dinoboards/V9958-Super/README.md

This repository has moved to Codeberg.

[https://codeberg.org/dinoboards/V9958-Super](https://codeberg.org/dinoboards/V9958-Super)

This repository is not mirrored.
