dinoboards/V9958-Super/docs/pcb-render.png

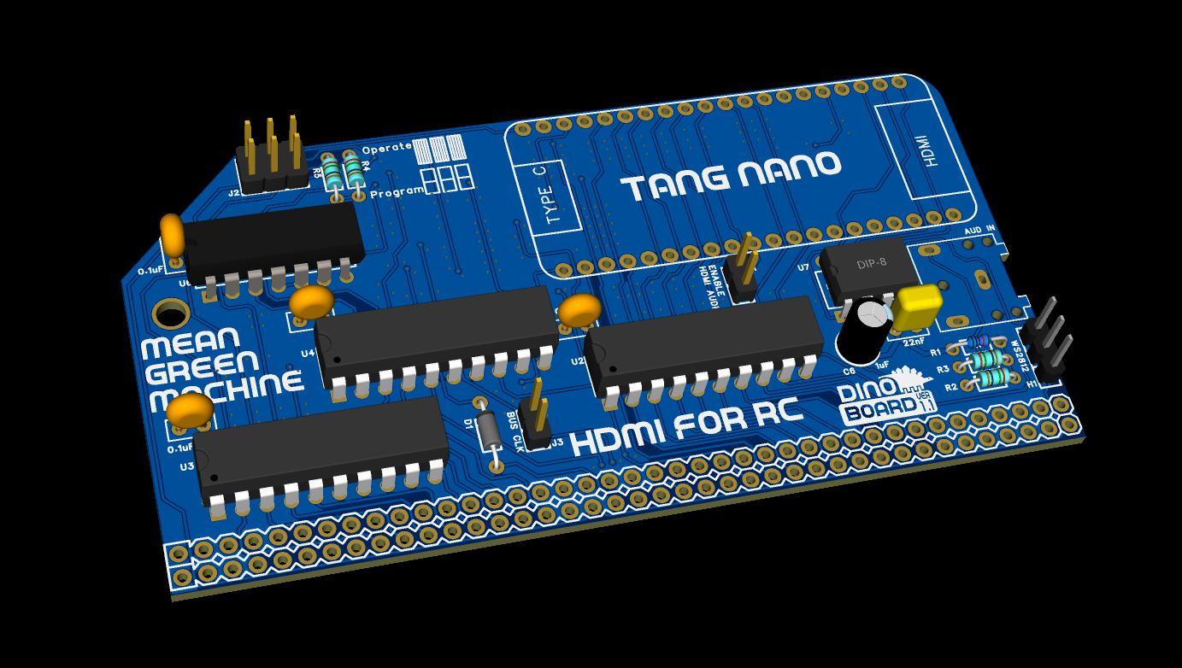
docs/pcb-render.png
