dinoboards/V9958-Super/(threads)

Thread 1 (2025-07-24):

TN GPIO pins 25 & 26 swapped in v9958.cst?

codesmythe, 2025-07-24:
Hi Dean,

Very nice work on this video board! I am particularly excited about your extensions to 640x480, etc video.

I had started down a similar path of a V9958 FPGA device hosted on the RCBus, but did not get very far. I did get a TN20K to RCBus host board designed and while adapting my schematic to your pinout, I noticed that pins TN20K pins 25 & 26  are swapped in the `v9958.cst` file compared to the schematic and PCB layout files you have published.

In the schematic and PCB layout files, TN_INT appears to be connected to TN GPIO pin 25, but `v9958.cst` has this line:

```
IO_LOC "int_n" 26;
```

Similarly, in the schematic and PCB layout files, the TN_25 signal (now misnamed?) (aka "exclude audio") appears to be connected to TN GPIO 26, but `v9958.cst` has this line:

```
IO_LOC "exclude_audio" 25
```

Anyway, nice job! I look forward to playing with the stuff you have made.

dinoboards, 2025-07-24:
Hi Rob,

Very good catch - i had completely forgotten about this issue.  And with my usual lack of discipline in documenting, I had to 'relearn' the issue again.

I did go through a small panic, until i had recalled and then doubled check.  Everything works - so...

The problem is in the footprint for the TN20K module.  The labels for those pins on the **Tang Nano 20K**  are wrong.  Hence why the trace `TN_25` seems to connect to TN20K's `26` pin.

I used EasyEDA for the schematic, and no doubt found a public version of the footprint --- and then discovered later the issue.  I need to update the footprint labels to avoid this confusion (I will leave this issue open as task to do that)

*I have a vague recall that there may have been a typo in a previous version of pinout diagram from Sipeed - and the footprint may have inherited that type - but I could be having an AI moment?*

I have also added a small note in the docs folder : [tn20k-pin-naming-discrepency.md](https://github.com/dinoboards/V9958-Super/blob/main/docs/tn20k-pin-naming-discrepency.md)

---

> Very nice work on this video board! I am particularly excited about your extensions to 640x480, etc video.

Thanks (despite the schematic confusion...)

dinoboards, 2025-07-27:
The schematic file has been updated with correct labels/pin assignement for the Tang Nano 20K - https://github.com/dinoboards/V9958-Super/blob/main/docs/schematic.pdf

Closed 2025-07-27.
