dinoboards/V9958-Super/docs/schematic1.1.pdf

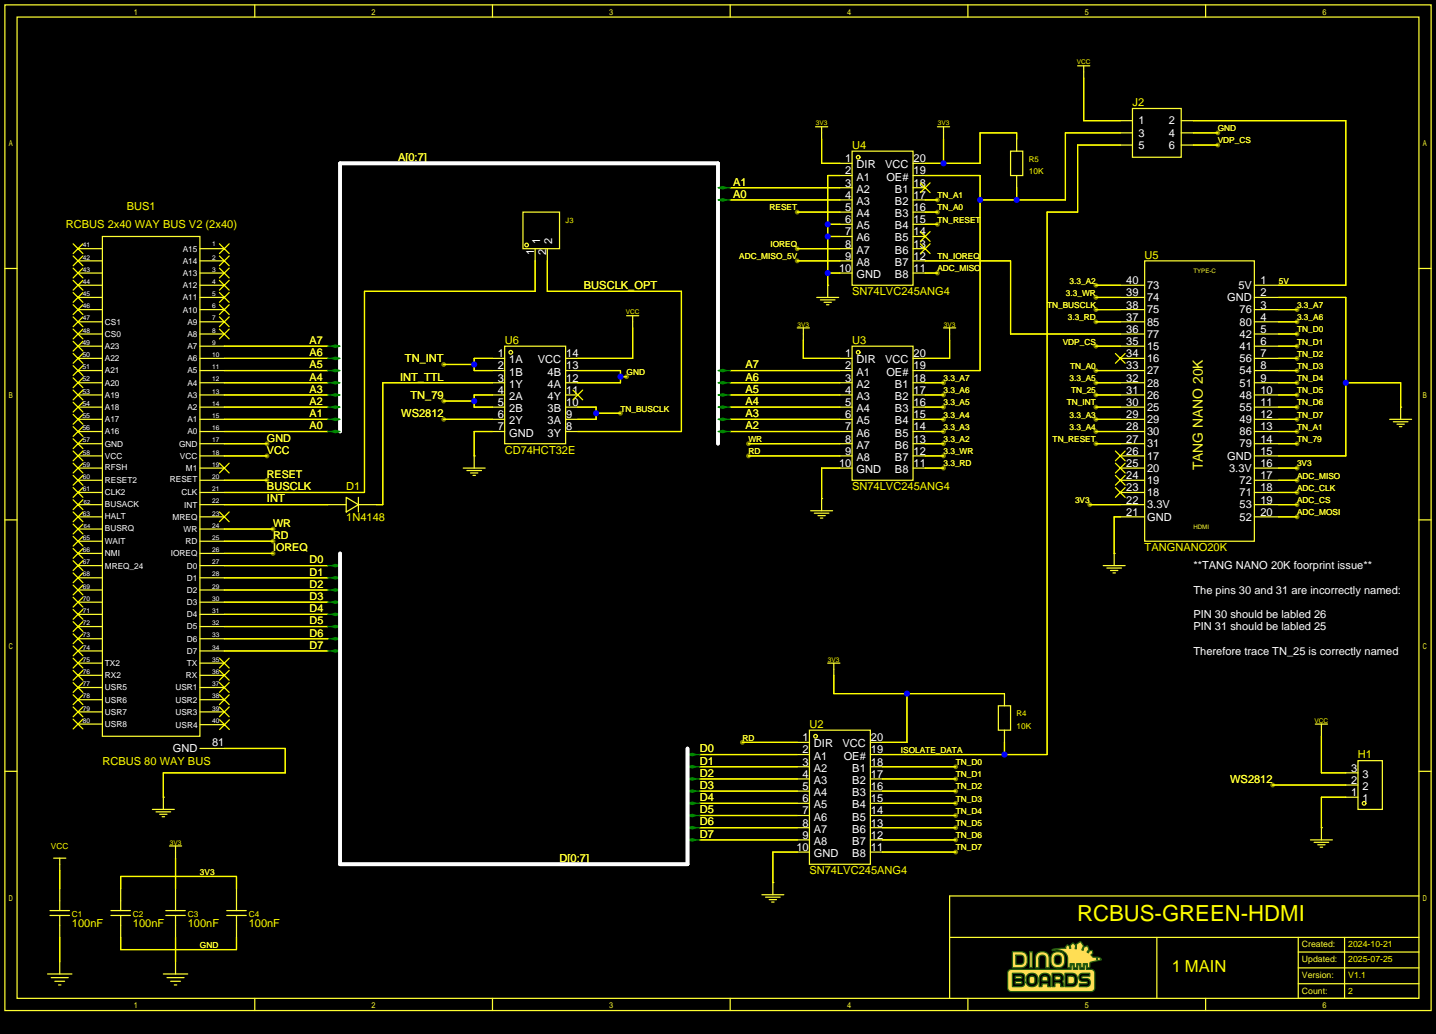
[picture p5: page 1]

**TANG NANO 20K foorprint issue**
The pins 30 and 31 are incorrectly named:
PIN 30 should be labled 26
PIN 31 should be labled 25
Therefore trace TN_25 is correctly named

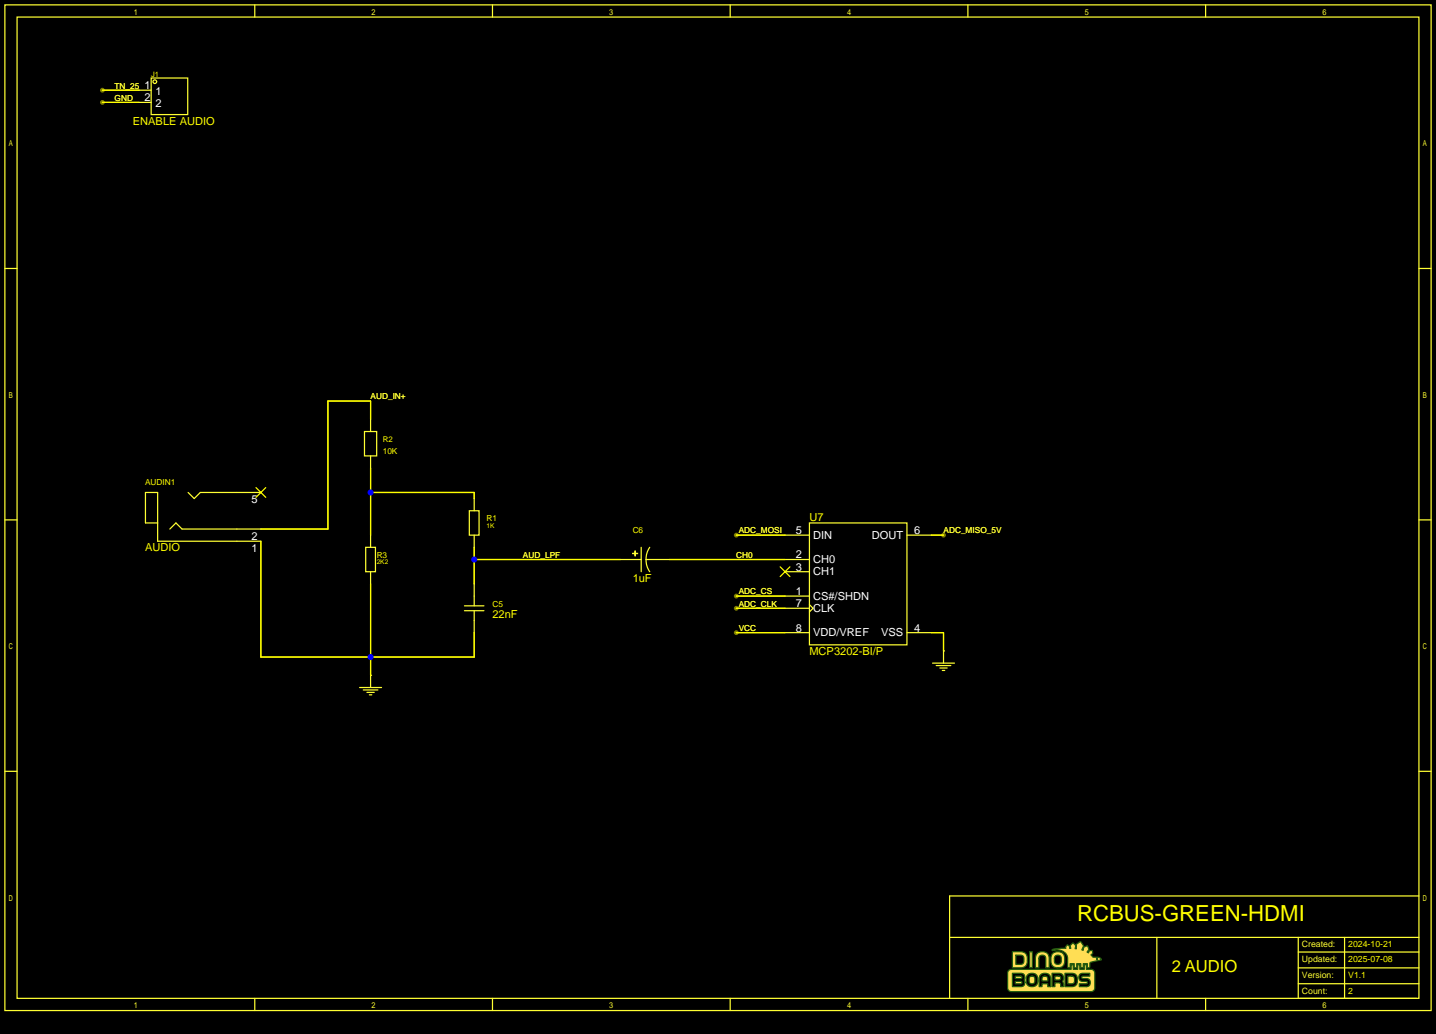
[picture p6: page 2]
