dinoboards/V9958-Super/docs/PCB-IMAGE.pdf

# Tang NanoHDMI

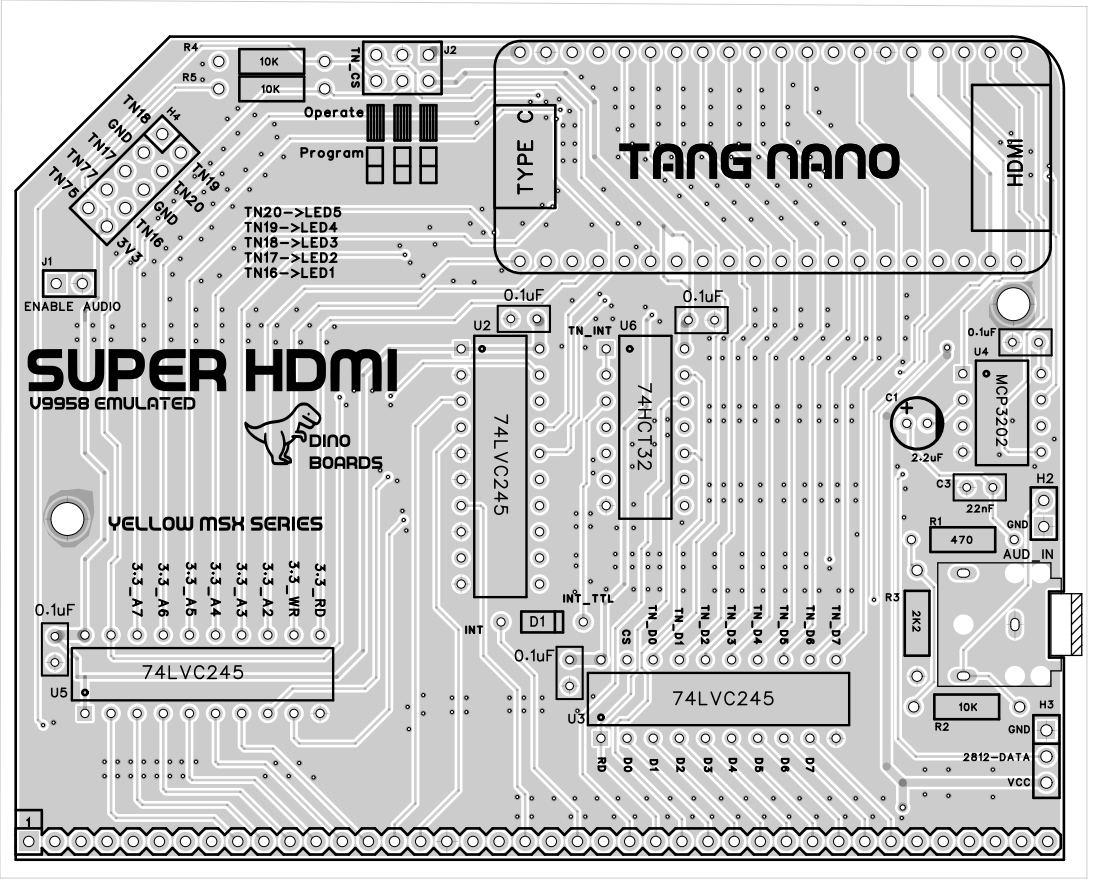
[picture p7: page 1]

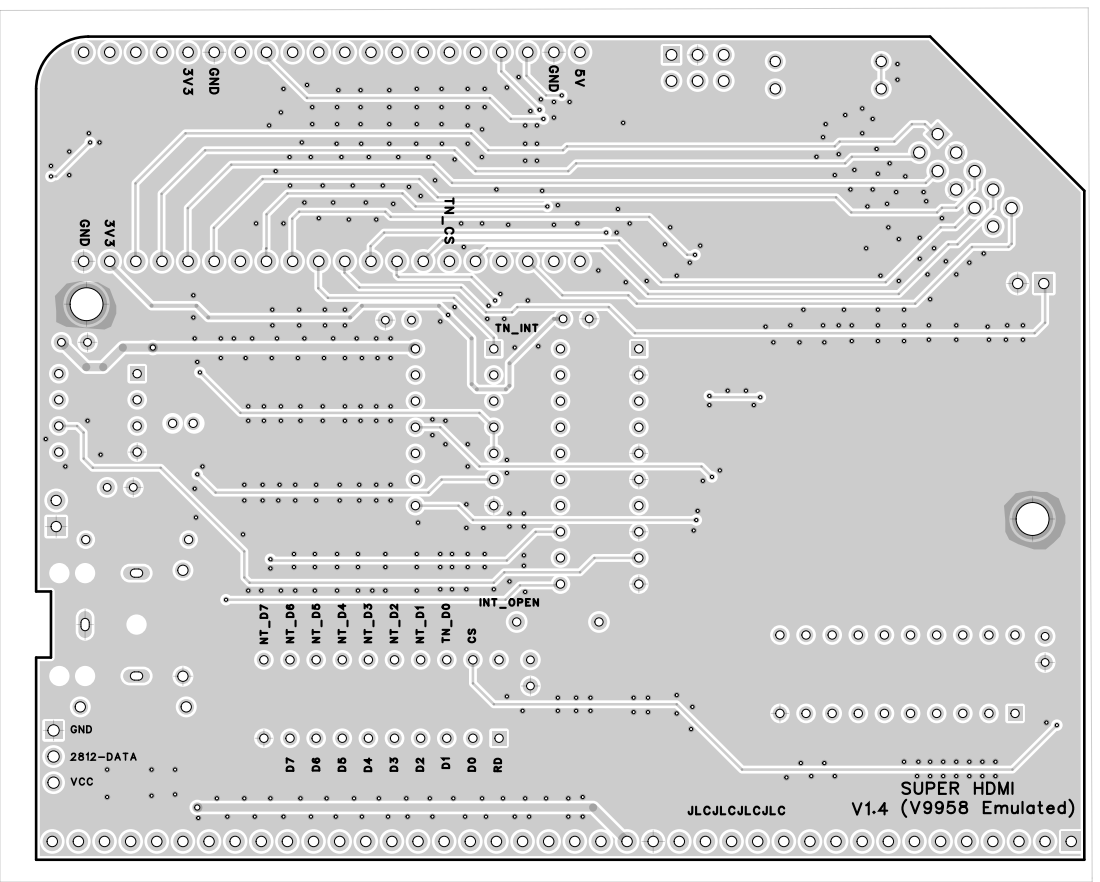
[picture p8: page 2]
