dinoboards/V9958-Super/src/vdp/address_bus.sv

`include "..\features.vh"

module ADDRESS_BUS #(
) (
    input bit          CLK21M,
    input bit          RESET,
    input bit   [ 1:0] DOTSTATE,
    input bit          PREWINDOW,
    input bit          REG_R1_DISP_ON,
    input bit   [ 2:0] EIGHTDOTSTATE,
    input bit          TXVRAMREADEN,
    input bit          PREWINDOW_X,
    input bit          PREWINDOW_Y_SP,
    input bit          SPVRAMACCESSING,
    input bit          TEXT_MODE,                 // TEXT MODE 1, 2 or 1Q
    input bit          VDPMODETEXT1,              // TEXT MODE 1      (SCREEN0 WIDTH 40)
    input bit          VDPMODETEXT1Q,             // TEXT MODE 1      (??)
    input bit          VDPMODEMULTI,              // MULTICOLOR MODE  (SCREEN3)
    input bit          VDPMODEMULTIQ,             // MULTICOLOR MODE  (??)
    input bit          VDPMODEGRAPHIC1,           // GRAPHIC MODE 1   (SCREEN1)
    input bit          VDPMODEGRAPHIC2,           // GRAPHIC MODE 2   (SCREEN2)
    input bit          VDPMODEGRAPHIC3,           // GRAPHIC MODE 2   (SCREEN4)
    input bit          VDPMODEGRAPHIC4,           // GRAPHIC MODE 4   (SCREEN5)
    input bit          VDPMODEGRAPHIC5,           // GRAPHIC MODE 5   (SCREEN6)
    input bit          VDPMODEGRAPHIC6,           // GRAPHIC MODE 6   (SCREEN7)
    input bit          VDPMODEGRAPHIC7,           // GRAPHIC MODE 7   (SCREEN8,10,11,12)
    input bit          VDPMODEISHIGHRES,          // TRUE WHEN MODE GRAPHIC5, 6
    input bit   [ 7:0] VDPVRAMACCESSDATA,
    input bit          VDPVRAMADDRSETREQ,
    input bit   [19:0] VDPVRAMACCESSADDRTMP,
    input bit          VDPVRAMWRREQ,
    input bit          VDPVRAMRDREQ,
    input bit          VDP_COMMAND_ACTIVE,
    input bit          vdp_cmd_vram_wr_req,
    input bit          vdp_cmd_vram_rd_req,
    input bit          VDPVRAMREADINGA,
    input bit          vdp_cmd_vram_rd_ack,
    input bit   [19:0] VDPCMDVRAMACCESSADDR,
    input bit   [ 7:0] VDP_CMD_VRAM_WR_DATA_8,
    input bit   [19:0] PRAMADRT12,
    input bit   [19:0] PRAMADRSPRITE,
    input bit   [19:0] PRAMADRG123M,
    input bit   [19:0] PRAMADRG4567,
    input bit          vdp_cmd_vram_reading_ack,

`ifdef ENABLE_SUPER_RES
    input bit          vdp_super,
    input logic [17:0] super_vram_addr,
    input bit super_res_drawing,
`endif

    output bit        vdp_cmd_vram_wr_ack,
    output bit        vdp_cmd_vram_reading_req,
    output bit        VDP_COMMAND_DRIVE,
    output bit [19:0] IRAMADR,
    output bit [ 7:0] PRAMDBO_8,
    output bit        PRAMWE_N,
    output bit        VDPVRAMREADINGR,
    output bit        VDPVRAMRDACK,
    output bit        VDPVRAMWRACK,
    output bit        VDPVRAMADDRSETACK

);

  localparam VRAM_ACCESS_IDLE = 0;
  localparam VRAM_ACCESS_DRAW = 1;
  localparam VRAM_ACCESS_CPUW = 2;
  localparam VRAM_ACCESS_CPUR = 3;
  localparam VRAM_ACCESS_SPRT = 4;
  localparam VRAM_ACCESS_VDPW = 5;
  localparam VRAM_ACCESS_VDPR = 6;
  localparam VRAM_ACCESS_VDPS = 7;

  bit [19:0] VDPVRAMACCESSADDR;

`ifdef ENABLE_SUPER_RES
  bit [17:0] __super_vram_addr;

  always_ff @(posedge RESET, posedge CLK21M) begin

    if (RESET == 1'b1) begin
      __super_vram_addr <= 0;
    end else begin
      __super_vram_addr <= super_vram_addr;
    end
  end
`endif

  always_ff @(posedge RESET, posedge CLK21M) begin : P1
    bit [19:0] VDPVRAMACCESSADDRV;
    bit [31:0] VRAMACCESSSWITCH;

    if ((RESET == 1'b1)) begin
      IRAMADR <= 20'b1;
      PRAMDBO_8 <= 8'bZ;
      PRAMWE_N <= 1'b1;
      VDPVRAMREADINGR <= 1'b0;
      VDPVRAMRDACK <= 1'b0;
      VDPVRAMWRACK <= 1'b0;
      VDPVRAMADDRSETACK <= 1'b0;
      VDPVRAMACCESSADDR <= 20'b0;
      vdp_cmd_vram_wr_ack <= 1'b0;
      vdp_cmd_vram_reading_req <= 1'b0;
      VDP_COMMAND_DRIVE <= 1'b0;

    end else begin

      // MAIN STATE
      //----------------------------------------
      //
      // VRAM ACCESS ARBITER.
      //

`ifdef ENABLE_SUPER_RES
        if (vdp_super && super_res_drawing && REG_R1_DISP_ON) begin
          VRAMACCESSSWITCH = VRAM_ACCESS_DRAW;

        end else
`endif
      // (The VRAM access timing is controlled by EIGHTDOTSTATE)
      if (DOTSTATE == 2'b10) begin

`ifdef ENABLE_SUPER_RES
        if(!vdp_super && ((PREWINDOW && REG_R1_DISP_ON) && (EIGHTDOTSTATE == 3'b000 || EIGHTDOTSTATE == 3'b001 || EIGHTDOTSTATE == 3'b010 || EIGHTDOTSTATE == 3'b011 || EIGHTDOTSTATE == 3'b100))) begin
`else
        if(((PREWINDOW && REG_R1_DISP_ON) && (EIGHTDOTSTATE == 3'b000 || EIGHTDOTSTATE == 3'b001 || EIGHTDOTSTATE == 3'b010 || EIGHTDOTSTATE == 3'b011 || EIGHTDOTSTATE == 3'b100))) begin
`endif
          //EIGHTDOTSTATE is 0 to 4, and displayed
          VRAMACCESSSWITCH = VRAM_ACCESS_DRAW;

`ifdef ENABLE_SUPER_RES
        end else if (!vdp_super && (PREWINDOW && REG_R1_DISP_ON && TXVRAMREADEN)) begin
`else
        end else if ((PREWINDOW && REG_R1_DISP_ON && TXVRAMREADEN)) begin
`endif
          // EIGHTDOTSTATE is 5 to 7, and displayed, and it is in text mode
          VRAMACCESSSWITCH = VRAM_ACCESS_DRAW;

        end else if (((PREWINDOW_X == 1'b1) && (PREWINDOW_Y_SP == 1'b1) && (SPVRAMACCESSING == 1'b1) && (EIGHTDOTSTATE == 3'b101) && (TEXT_MODE == 1'b0))) begin
          // FOR SPRITE Y-TESTING
          VRAMACCESSSWITCH = VRAM_ACCESS_SPRT;

        end else if(((PREWINDOW_X == 1'b0) && (PREWINDOW_Y_SP == 1'b1) && (SPVRAMACCESSING == 1'b1) && (TEXT_MODE == 1'b0) && ((EIGHTDOTSTATE == 3'b000) || (EIGHTDOTSTATE == 3'b001) || (EIGHTDOTSTATE == 3'b010) || (EIGHTDOTSTATE == 3'b011) || (EIGHTDOTSTATE == 3'b100) || (EIGHTDOTSTATE == 3'b101)))) begin
          // FOR SPRITE PREPAREING
          VRAMACCESSSWITCH = VRAM_ACCESS_SPRT;

        end else if ((VDPVRAMWRREQ != VDPVRAMWRACK)) begin
          // VRAM WRITE REQUEST BY CPU
          VRAMACCESSSWITCH = VRAM_ACCESS_CPUW;

        end else if ((VDPVRAMRDREQ != VDPVRAMRDACK)) begin
          // VRAM READ REQUEST BY CPU
          VRAMACCESSSWITCH = VRAM_ACCESS_CPUR;

        end else begin
          // VDP COMMAND
          if ((VDP_COMMAND_ACTIVE == 1'b1)) begin
            if ((vdp_cmd_vram_wr_req != vdp_cmd_vram_wr_ack)) begin
              VRAMACCESSSWITCH = VRAM_ACCESS_VDPW;
            end else if ((vdp_cmd_vram_rd_req != vdp_cmd_vram_rd_ack)) begin
              VRAMACCESSSWITCH = VRAM_ACCESS_VDPR;
            end else begin
              VRAMACCESSSWITCH = VRAM_ACCESS_VDPS;
            end
          end else begin
            VRAMACCESSSWITCH = VRAM_ACCESS_VDPS;
          end
        end

      end else begin
        //DOTSTATE != 2'b10
        VRAMACCESSSWITCH = VRAM_ACCESS_DRAW;
      end

      if ((VRAMACCESSSWITCH == VRAM_ACCESS_VDPW || VRAMACCESSSWITCH == VRAM_ACCESS_VDPR || VRAMACCESSSWITCH == VRAM_ACCESS_VDPS)) begin
        VDP_COMMAND_DRIVE <= 1'b1;
      end else begin
        VDP_COMMAND_DRIVE <= 1'b0;
      end

      //
      // VRAM ACCESS ADDRESS SWITCH
      //
      if ((VRAMACCESSSWITCH == VRAM_ACCESS_CPUW)) begin
        IRAMADR <= VDPVRAMACCESSADDR;

        if(((VDPMODETEXT1 == 1'b1) || (VDPMODETEXT1Q == 1'b1) || (VDPMODEMULTI == 1'b1) || (VDPMODEMULTIQ == 1'b1) || (VDPMODEGRAPHIC1 == 1'b1) || (VDPMODEGRAPHIC2 == 1'b1))) begin
          VDPVRAMACCESSADDR[13:0] <= 14'(VDPVRAMACCESSADDR[13:0] + 1);
        end else begin
          VDPVRAMACCESSADDR <= 20'(VDPVRAMACCESSADDR + 1); //TODO: has extending the bit width broken compatibility with non super res modes
        end
        PRAMDBO_8 <= VDPVRAMACCESSDATA;
        PRAMWE_N <= 1'b0;
        VDPVRAMWRACK <= ~VDPVRAMWRACK;

      end else if ((VRAMACCESSSWITCH == VRAM_ACCESS_CPUR)) begin
        // VRAM READ BY CPU
        if ((VDPVRAMADDRSETREQ != VDPVRAMADDRSETACK)) begin
          VDPVRAMACCESSADDRV = VDPVRAMACCESSADDRTMP;
          // CLEAR VRAM ADDRESS SET REQUEST SIGNAL
          VDPVRAMADDRSETACK <= ~VDPVRAMADDRSETACK;
        end else begin
          VDPVRAMACCESSADDRV = VDPVRAMACCESSADDR;
        end

        IRAMADR <= VDPVRAMACCESSADDRV;

        if(((VDPMODETEXT1 == 1'b1) || (VDPMODETEXT1Q == 1'b1) || (VDPMODEMULTI == 1'b1) || (VDPMODEMULTIQ == 1'b1) || (VDPMODEGRAPHIC1 == 1'b1) || (VDPMODEGRAPHIC2 == 1'b1))) begin
          VDPVRAMACCESSADDR[13:0] <= 14'(VDPVRAMACCESSADDRV[13:0] + 1);
        end else begin
          VDPVRAMACCESSADDR <= 20'(VDPVRAMACCESSADDRV + 1);
        end
        PRAMDBO_8 <= 8'bZ;
        PRAMWE_N <= 1'b1;
        VDPVRAMRDACK <= ~VDPVRAMRDACK;
        VDPVRAMREADINGR <= ~VDPVRAMREADINGA;

      end else if ((VRAMACCESSSWITCH == VRAM_ACCESS_VDPW)) begin
        IRAMADR <= VDPCMDVRAMACCESSADDR;
        PRAMDBO_8 <= VDP_CMD_VRAM_WR_DATA_8;
        PRAMWE_N <= 1'b0;
        vdp_cmd_vram_wr_ack <= ~vdp_cmd_vram_wr_ack;

      end else if ((VRAMACCESSSWITCH == VRAM_ACCESS_VDPR)) begin
        IRAMADR <= VDPCMDVRAMACCESSADDR;
        PRAMDBO_8 <= 8'bZ;
        PRAMWE_N <= 1'b1;
        vdp_cmd_vram_reading_req <= ~vdp_cmd_vram_reading_ack;

      end else if ((VRAMACCESSSWITCH == VRAM_ACCESS_SPRT)) begin
        // VRAM READ BY SPRITE MODULE
        IRAMADR <= PRAMADRSPRITE;
        PRAMWE_N <= 1'b1;
        PRAMDBO_8 <= 8'bZ;
      end else begin
        // VRAM_ACCESS_DRAW
        // VRAM READ FOR SCREEN DRAWING

`ifdef ENABLE_SUPER_RES
        if (vdp_super) begin
          IRAMADR <= {__super_vram_addr, 2'b00};
          PRAMDBO_8 <= 8'bZ;
          PRAMWE_N <= 1'b1;
        end else begin
`endif
          case (DOTSTATE)
            2'b10: begin
              PRAMDBO_8  <= 8'bZ;
              PRAMWE_N   <= 1'b1;
              if ((TEXT_MODE == 1'b1)) begin
                IRAMADR <= PRAMADRT12;
              end else if (((VDPMODEGRAPHIC1 == 1'b1) || (VDPMODEGRAPHIC2 == 1'b1) || (VDPMODEGRAPHIC3 == 1'b1) || (VDPMODEMULTI == 1'b1) || (VDPMODEMULTIQ == 1'b1))) begin
                IRAMADR <= PRAMADRG123M;
              end else if (((VDPMODEGRAPHIC4 == 1'b1) || (VDPMODEGRAPHIC5 == 1'b1) || (VDPMODEGRAPHIC6 == 1'b1) || (VDPMODEGRAPHIC7 == 1'b1))) begin
                IRAMADR <= PRAMADRG4567;
              end
            end
            2'b01: begin
              PRAMDBO_8  <= 8'bZ;
              PRAMWE_N   <= 1'b1;
              if (((VDPMODEGRAPHIC6 == 1'b1) || (VDPMODEGRAPHIC7 == 1'b1))) begin
                IRAMADR <= PRAMADRG4567;
              end
            end
            default: begin
            end
          endcase
        end

        if (((DOTSTATE == 2'b11) && (VDPVRAMADDRSETREQ != VDPVRAMADDRSETACK))) begin
          VDPVRAMACCESSADDR <= VDPVRAMACCESSADDRTMP;
          VDPVRAMADDRSETACK <= ~VDPVRAMADDRSETACK;
        end
`ifdef ENABLE_SUPER_RES
      end
`endif
    end
  end

endmodule
