dinoboards/V9958-Super/src/vdp/vdp_super_half_2ppb_res.sv

`define DISPLAYED_PIXEL_WIDTH 720
`define DISPLAYED_PIXEL_HEIGHT PIXEL_HEIGHT(pal_mode)

/*

16 colours

REG_R9_Y_DOTS: 1
 super res @50hz 720x288
 super res @60hz 720x240

*/


module VDP_SUPER_HALF_2PPB_RES (
    input bit reset,
    input bit clk,
    input bit last_line,
    input bit vdp_super,
    input bit on_a_visible_line,
    input bit [9:0] ext_reg_view_port_start_x,
    input bit [9:0] ext_reg_view_port_end_x,
    input bit [16:0] ext_reg_super_res_page_addr,
    input bit [7:0] REG_R7_FRAME_COL,
    input bit super_res_visible,
    input bit [31:0] vrm_32,
    input bit [9:0] cx,
    input bit [9:0] cy,

    output bit [17:0] super_half_2ppb_res_vram_addr,
    output bit [ 7:0] super_half_2ppb_res_palette_addr
);

  import custom_timings::*;

  bit [31:0] vrm_32_1;
  bit [31:0] vrm_32_2;
  bit odd_phase;
  bit active_line;  // true if line is drawn from sdram, false if drawn from line buffer
  bit [3:0] line_buffer[720];
  bit [3:0] first_pixel;
  bit [9:0] line_buffer_index;

  /*
  Pixel sets
  7:4
  3:0

  15:12
  11:8

  23:20
  19:16

  31:28
  27:24
  */

  assign active_line = (cy[0] == 0);

  always_ff @(posedge reset or posedge clk) begin
    if (reset | ~vdp_super) begin
      super_half_2ppb_res_vram_addr <= 0;
      vrm_32_1 <= '{default: 0};
      odd_phase <= 0;

    end else begin
      case (cx)
        720: begin
          if (last_line) begin
            super_half_2ppb_res_vram_addr <= ext_reg_super_res_page_addr;
            //reset address to start
            //data read at 725 into vrm_32_1
          end
          line_buffer_index <= 0;
        end

        724: begin  // cycle cx[1:0] == 0
          if (last_line) begin
            super_half_2ppb_res_vram_addr <= 18'(super_half_2ppb_res_vram_addr + 1);
            //request 2nd set of pixels : equiv of addr <= 1
            //read in state 3 straight into super_half_2ppb_res_palette_addr
          end
        end

        725: begin  //cycle cx[1:0] == 1
          if (last_line) begin
            vrm_32_1 <= vrm_32;  //pixels 0..3
            // for the last line of frame (not visible)
            //capture the data - assume this for first pixels
            //top/left corner
            // this is not 'apparently' impacted by addr change in 724
          end
        end

        856: begin
          if (!active_line || last_line) begin
            super_half_2ppb_res_palette_addr <= vrm_32_1[7:4];
            first_pixel = vrm_32_1[7:4];
            line_buffer[line_buffer_index] <= vrm_32_1[7:4];

          end else begin
            super_half_2ppb_res_palette_addr <= line_buffer[line_buffer_index];
            first_pixel <= line_buffer[line_buffer_index];

          end
          line_buffer_index <= 10'(line_buffer_index + 1);
        end

        ext_reg_view_port_start_x: begin  //default: frame-width -1
          if (on_a_visible_line) begin
            super_half_2ppb_res_palette_addr <= first_pixel;
          end
        end

        ext_reg_view_port_end_x: begin
          super_half_2ppb_res_palette_addr <= REG_R7_FRAME_COL;
          odd_phase <= 0;
        end

        default begin
          if (!super_res_visible) begin
            super_half_2ppb_res_palette_addr <= REG_R7_FRAME_COL;

          end else begin
            case ({
              odd_phase, cx[1:0]
            })
              0: begin
                if (active_line) begin
                  vrm_32_2 <= vrm_32_1;
                  super_half_2ppb_res_palette_addr <= vrm_32_1[3:0];
                  line_buffer[line_buffer_index]   <= vrm_32_1[3:0];
                  super_half_2ppb_res_vram_addr <= 18'(super_half_2ppb_res_vram_addr + 1);


                end else begin
                  super_half_2ppb_res_palette_addr <= line_buffer[line_buffer_index];
                end

                line_buffer_index <= 10'(line_buffer_index + 1);
              end

              1: begin
                if (active_line) begin
                  super_half_2ppb_res_palette_addr <= vrm_32_1[15:12];
                  line_buffer[line_buffer_index]   <= vrm_32_1[15:12];
                  vrm_32_1 <= vrm_32;  //capture next 4 bytes
                end else begin
                  super_half_2ppb_res_palette_addr <= line_buffer[line_buffer_index];
                end

                line_buffer_index <= 10'(line_buffer_index + 1);
              end

              2: begin
                if (active_line) begin
                  super_half_2ppb_res_palette_addr <= vrm_32_2[11:8];
                  line_buffer[line_buffer_index]   <= vrm_32_2[11:8];
                end else begin
                  super_half_2ppb_res_palette_addr <= line_buffer[line_buffer_index];
                end

                line_buffer_index <= 10'(line_buffer_index + 1);
              end


              3: begin
                if (active_line) begin
                  super_half_2ppb_res_palette_addr <= vrm_32_2[23:20];
                  line_buffer[line_buffer_index]   <= vrm_32_2[23:20];
                  odd_phase <= 1;
                end else begin
                  super_half_2ppb_res_palette_addr <= line_buffer[line_buffer_index];
                end

                line_buffer_index <= 10'(line_buffer_index + 1);
                odd_phase <= 1;
              end

              4: begin
                if (active_line) begin
                  super_half_2ppb_res_palette_addr <= vrm_32_2[19:16];
                  line_buffer[line_buffer_index]   <= vrm_32_2[19:16];
                end else begin
                  super_half_2ppb_res_palette_addr <= line_buffer[line_buffer_index];
                end

                line_buffer_index <= 10'(line_buffer_index + 1);
              end

              5: begin
                if (active_line) begin
                  super_half_2ppb_res_palette_addr <= vrm_32_2[31:28];
                  line_buffer[line_buffer_index]   <= vrm_32_2[31:28];
                end else begin
                  super_half_2ppb_res_palette_addr <= line_buffer[line_buffer_index];
                end

                line_buffer_index <= 10'(line_buffer_index + 1);
              end

              6: begin
                if (active_line) begin
                  super_half_2ppb_res_palette_addr <= vrm_32_2[27:24];
                  line_buffer[line_buffer_index]   <= vrm_32_2[27:24];
                end else begin
                  super_half_2ppb_res_palette_addr <= line_buffer[line_buffer_index];
                end

                line_buffer_index <= 10'(line_buffer_index + 1);
              end

              7: begin
                if (active_line) begin
                  super_half_2ppb_res_palette_addr <= vrm_32_1[7:4];
                  line_buffer[line_buffer_index]   <= vrm_32_1[7:4];

                end else begin
                  super_half_2ppb_res_palette_addr <= line_buffer[line_buffer_index];
                end

                line_buffer_index <= 10'(line_buffer_index + 1);
                odd_phase <= 0;
              end
            endcase
          end
        end
      endcase
    end
  end

endmodule
