dinoboards/V9958-Super/src/clocks.v

`include "vdp_constants.vh"

module clocks (
    // assumed to be 27Mhz
    input clk,

    // active low RESET signal
    input rst_n,

    // the buffered 27Mhz clock
    output clk_w,

    // generated 135Mhz pixel clock for use with by the HDMI serializer
    output clk_135_w,
    // lock status of the 135Mhz clock
    output clk_135_lock_w,

    // generated 44.1khz clock for the HDMI audio stream
    output clk_audio_w,

    // generated clocks and lock for the SDRAM
    output clk_sdram_w,
    output clk_sdramp_w,
    output clk_sdram_lock_w,

    output clk_bus
);

  bit clk_135;
  bit clk_audio;
  bit clk_sdram;
  bit clk_sdramp;

  bit _clk_bus;             // cpu clock out
  bit [31:0] accumulator;   // counter for cpu clock out calculations

  // Main 27Mhz Clock
  BUFG clk_bufg_inst (
      .I(clk),
      .O(clk_w)
  );

  // 135Mhz Clock pixel clock
  CLK_135 clk_135_inst (
      .clkin (clk),
      .reset (~rst_n),
      .clkout(clk_135),
      .lock  (clk_135_lock_w)
  );

  BUFG clk_135_bufg_inst (
      .I(clk_135),
      .O(clk_135_w)
  );

  // 44.1khz HDMI Audio clock
  CLOCK_DIV #(
      .CLK_SRC(27),
      .CLK_DESIRED(0.044100),
      .PRECISION_BITS(16)
  ) audio_clk (
      .clk_src(clk_w),
      .clk_desired(clk_audio)
  );

  BUFG clk_audio_bufg_inst (
      .I(clk_audio),
      .O(clk_audio_w)
  );

  // 108Mhz Clock for RAM
  CLK_108P clk_sdramp_inst (
      .clkin(clk),
      .reset(~rst_n),
      .clkout(clk_sdram),
      .lock(clk_sdram_lock_w),
      .clkoutp(clk_sdramp)
  );

  BUFG clk_sdram_bufg_inst (
      .I(clk_sdram),
      .O(clk_sdram_w)
  );

  BUFG clk_sdramp_bufg_inst (
      .I(clk_sdramp),
      .O(clk_sdramp_w)
  );

  // Generate a standard MSX ~3.58Mhz clock signal
  // for use by the CPU
  // given our source clock is 27Mhz - there will be
  // some jitter
  // Step value calculated for 27MHz -> 3.579545MHz
  // (3.579545 / 27.0) * 2^32 = 569408471
  localparam [31:0] STEP = 32'd569408471;

  always @(posedge clk_w or negedge rst_n) begin
    if (rst_n == 0) begin
      accumulator <= 32'h0;
      _clk_bus     <= 1'b0;
    end else begin
      // Accumulate the step value every clock cycle
      accumulator <= accumulator + STEP;

      // The Most Significant Bit (MSB) acts as the divided clock
      // This naturally toggles at the target frequency
      _clk_bus <= accumulator[31];
    end
  end

  assign clk_bus = _clk_bus;

endmodule
