dinoboards/V9958-Super/(commit log)

2024-02-25 Removed all but V3 of the V9558 FPGA implementation and moved to root
    [device.cfg, mainboard.kicad_pcb, mainboard.kicad_sch, nabu-backplate.FCStd, nabu-backplate.stl, socket.kicad_pcb, socket.kicad_sch, tn_vdp_v1_compact.csv]
2024-02-25 switch order of data lines to align with schematic
2024-02-25 removed the use of pin PIN79_WS2812
2024-02-25 replaced csr and csw with just cs removing need for one the buffer chips
    [v9958_top.v]
2024-02-25 adjusted pin assignments to avoid use of LED IO assignments
2024-03-01 vdp_command: investigating compatibility issue - wip
    [vdp_command.v]
2024-03-01 verilog conversion - reverted back to vdp_command.vhd - due to unresolved issue with vdp_command.v conversion
    [vdp_command.sv]
2024-03-01 fixed some gowin syn warnings
    [audio_clock_regeneration_packet.sv, clockdiv.v, hdmi.sv, serializer.sv, v9958_top.v, vdp_colordec.v]
2024-03-01 hdmi.v - fixed warning for initialising input logic cx, cy
    [hdmi.sv]
2024-03-01 vdp_colordec: fixed incorrect assignment for W_GRP7_SPRITE_COLOR
    [vdp_colordec.v]
2024-03-02 audio_sample_packet/packet_picker: minor formatting adjustment and removed a couple of warnings
2024-03-02 pin 25 - dvi_output - now drives selection of dvi or true hdmi output
2024-03-02 refactor master reset signal (reset_n) - and removed use of the onboard button
    [v9958_top.v]
2024-03-03 bit sizes for x and y dimensions normalised to avoid potential overflow for larger resolutions
    [hdmi.sv, v9958_top.v, video_output.v]
2024-03-06 rework the sync'ing of cx/cy from vdp to hdmi stream - and only 'reset' the hdmi component when needed.
    [hdmi_output.v, hdmi_selection.v, v9958_top.v, vdp.v, vdp_colordec.v, vdp_hvcounter.v, vdp_ssg.v]
2024-03-07 hdmi cx, cy is now injected into VDP logic - so avoiding need for syncing of coords
    [hdmi.sv, hdmi_output.v, hdmi_selection.v, v9958_top.v, vdp.v, vdp_hvcounter.v, vdp_package.v, vdp_ssg.v]
2024-03-08 vdp_command.sv: refactoring in search of conversion bug
    [vdp_command.sv]
2024-03-09 vdp_command.sv: refactoring in search of conversion bug (YCOUNTDELTA)
    [vdp_command.sv]
2024-03-09 vdp_command.sv: refactoring in search of conversion bug (MAXXMASK)
    [vdp_command.sv]
2024-03-09 vdp_command.sv: refactoring in search of conversion bug (RDPOINT, RDXLOW)
    [vdp_command.sv]
2024-03-09 vdp_command.sv: refactoring in search of conversion bug (LOGOPDESTCOL, COLMASK)
    [vdp_command.sv]
2024-03-09 vdp_command.sv: refactoring in search of conversion bug (NXLOOPEND)
    [vdp_command.sv]
2024-03-09 vdp_command.sv: refactoring in search of conversion bug (XCOUNTDELTA)
    [vdp_command.sv]
2024-03-09 vdp_command.sv: refactoring in search of conversion bug (reset state of some ff)
    [vdp_command.sv]
2024-03-09 vdp_command.sv: refactoring in search of conversion bug (VRAMACCESSADDR)
    [vdp_command.sv]
2024-03-09 vdp_command: fixed issue with conversion for vdp. LMMC was incorrectly applying a mask to the incoming byte from the CPU
    [vdp_command.sv]
2024-03-10 refactor: renamed sdram/memory_controller's pins to aligned with Gowin special magic pin names
2024-03-12 vdp: removed BWINDOW_X - no longer used/needed
    [vdp.v]
2024-03-15 common-functions: removed CLOCKS_PER_LINE and added FRAME_HEIGHT
2024-03-16 vdp-super: corrections to of resolutions/memory usage docs
    [vdp_register.v]
2024-03-19 vdp-super-res: refactor: removed dot_state - and replaced with cx[1:0] - they are always the same
    [vdp_super_high_res.sv]
2024-03-20 super-res: fixed issue with 60hz mode
    * pixel 2-3 of row 1 would merge - pixel rendering for row 1 advanced actual addr
    * the byte for pixel 2 of row 2 was skiped, addr was re-sync - but all preceeding pixel were
    out of alignment
    * fix was to apply the addr change within the DR state. No idea why this only happend in 60Hz mode
    [v9958_top.v, vdp_super_high_res.sv]
2024-03-20 revert #a9db57c06f094f101faead83f3bcd66996aa5311 - as it was correct
    [hdmi.sv, hdmi_output.v, hdmi_selection.v, v9958_top.v, vdp_super_high_res.sv]
2024-03-22 audio: removed LPF - its been replaced with RC LPF applied to audio input signal
    [SPI_MCP3202.v, audio.sv, clockdiv.v, clocks.v, v9958_top.v]
2024-03-30 refactoring MEMORY_CONTROLLER - track bit width for reads and writes seperatly
2024-03-31 super-res: possible fix for strange issue with having a vram increment of anything other than 4
    [vdp_super_res.sv]
2024-03-31 super-mid: adjust vram address calculation for correct x by y. Seems to be issue with synth difference with TCL and IDE
    [address_bus.sv, vdp_command.sv, vdp_super_res.sv]
2024-03-31 super-mid: fix RGB colour translation from 24 bit to 16 bit
    [vdp_command.sv, vdp_super_res.sv]
2024-04-05 super-res: track vram address 32bit word boundary - reduce number of bits required to track for super res
2024-04-05 removed signal hdmi_reset - seems to reduce timing/startup issue
    [hdmi_selection.v, v9958_top.v]
2024-04-05 Refactor: memory_controller no longer outputs direct sram data - only the FF data - which is what it always was doing anyway. This improved the timing reports as it shows we never had hold/setup issu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
    [memory_controller.sv, vdp_sprite.v]
2024-04-05 Refactor: memory controller. Only use the FF din32 data, as thats all thats needed. Reduces the number of hold/setup timing issues reported
    [memory_controller.sv]
2024-04-05 audio: correct pin assignment for PCB V1.2
    [audio.sv]
2024-04-05 fix issue with vram writing from cpu when in super mode. Added ws2812 driver
    [v9958_top.v, vdp_super_res.sv, ws2812.sv]
2024-04-05 packet-picker: refactor packet/frame delivery to avoid synth warnings of undriven headers/subs
    [audio_clock_regeneration_packet.sv, audio_info_frame.sv, audio_sample_packet.sv, auxiliary_video_information_info_frame.sv, hdmi.sv, packet_picker.sv, source_product_description_info_frame.sv]
2024-04-05 packet-picker: fixed timing error for audio_sample_word -> audio_sample_word_transfer
    [clocks.v, packet_picker.sv]
2024-04-06 build.sh: extract some key elements from the timing report and print out at end of each build
2024-04-06 resolved all hold timing violations
    [cpu_io.sv, v9958_top.v]
2024-04-07 super-mid: fixed issue with set/line commands not calculating vram address correctly
    [vdp_command.sv]
2024-04-07 added small 'experiments' project and noted issue with resource allocations for multiplication operations
    [top.sv]
2024-04-20 POINT: fix issue for retrieving 8 bit colour register
    [vdp_command.sv]
2024-04-20 Super: fixed issue with reading and applying logical operations to pixels in super mid mode
    [address_bus.sv, vdp.v, vdp_command.sv]
2024-04-21 docs: updated README and added schematic and PCB images
2024-04-25 docs: updated schematic - adjustment to audio processing
2024-04-26 WS2812: fix: updated to use the correct clock signal - clk_w
    [v9958_top.v]
2024-05-10 audio: fix warning for param/localparam
    [SPI_MCP3202.v]
2024-11-08 fix regression of mode 7 due to incorrect calculations of cx and horz_count
    [vdp_ssg.v]
2024-11-08 updated pin assignment to aligned with green pcb v1
2025-03-13 ENABLE_SUPER_RES: fixed issue with setting not configured correctly
    [memory_controller.sv, v9958_top.sv, vdp.sv, vdp_register.sv]
2025-03-14 ENABLE_SUPER_RES: refactor storage and wiring of palette registers
2025-03-15 ENABLE_SUPER_RES: super res fix pixel phasing
    [address_bus.sv, vdp.sv, vdp_register.sv, vdp_super_res.sv]
2025-03-15 ENABLE_SUPER_RES: super mid now uses palette current res is (360x576)
2025-03-15 ENABLE_SUPER_RES: super res - fixed issue where first column was corrupted"
    [vdp_super_res.sv]
2025-03-16 ENABLE_SUPER_RES: fix timing issue with high res at 60hz
    [vdp_super_res.sv]
2025-03-16 ENABLE_SUPER_RES: adjusted vram bus arbitration for 60hz modes
2025-03-16 ENABLE_SUPER_RES: additional adjusted vram bus arbitration for 60hz modes mid resolutions
2025-03-20 ENABLE_SUPER_RES: extended registers initialised on reset
    [vdp_register.sv]
2025-03-20 ENABLE_SUPER_RES: fix conflict during loading of top left pixel
    [vdp_super_res.sv]
2025-03-20 ENABLE_SUPER_RES: enable seperate width values for 50/60hz modes
2025-03-20 ENABLE_SUPER_RES: added command to reset 50hz resolution settings
    [vdp_register.sv]
2025-03-20 ENABLE_SUPER_RES: re-ordered extended registers - all 50hz first, then the 60hz variants
2025-03-22 ENABLE_SUPER_RES: fix issue LMMM vram to vram command
    [memory_controller.sv, v9958_top.sv, vdp.sv, vdp_command.sv]
2025-03-22 ENABLE_SUPER_RES: fix is 60hz mode with reduced viewport - frame 0 was always showing pixel 0
    [vdp_register.sv, vdp_super_res.sv]
2025-03-31 ENABLE_SUPER_RES: Fixes for last/first pixel alignment - super_mid2 still not correct
    [vdp_super_res.sv]
2025-04-01 ENABLE_SUPER_RES: revert super_mid2 - strange unpredictable timing issues
    [vdp.sv, vdp_command.sv, vdp_register.sv, vdp_super_res.sv]
2025-04-01 ENABLE_SUPER_RES: pipeline FRAME_HEIGHT to reduce latency risks
2025-04-01 ENABLE_SUPER_RES: pipeline FRAME_WIDTH to reduce latency risks
2025-04-03 SUPER_HIGH_RES: removed unused flip-flop assignment
    [vdp_super_res.sv]
2025-07-23 readme: added not to advise to not power while flashing the 20K
2025-07-24 docs: added quick note descriping doc issue with pin 25/26
2025-07-24 docs: fixed issue with schematic's incorrect naming of pins 25 and 26
2025-07-26 superes:mid: fix issue with extra half pixel drawn to right of viewport
    [vdp_super_mid_res.sv]
2025-08-09 superres: fix VRAM direct address not supporting full 20bit address loading into R#14
    [vdp_register.sv]
2025-08-24 Added a live indicator blinking led
2026-05-08 super high res: fixed issue where first 4 pixels (top-left) were incorrectly rendered
    The first 4 pixels were mirroring the next 4 pixels (2nd word was mapped to first word)
    [vdp_super_high_res.sv]
2026-05-08 super half res: fixed issue where first 4 pixels (top-left) were incorrectly rendered
    [vdp_super_half_res.sv]
2026-05-08 fixed issue with half res 2bpp first column mis-alignment
    [v99x8.h, vdp_super_half_2ppb_res.sv]
